croane651/MAE-342-Project/MEE342_Geneva_Drive_Assem1.SLDASM

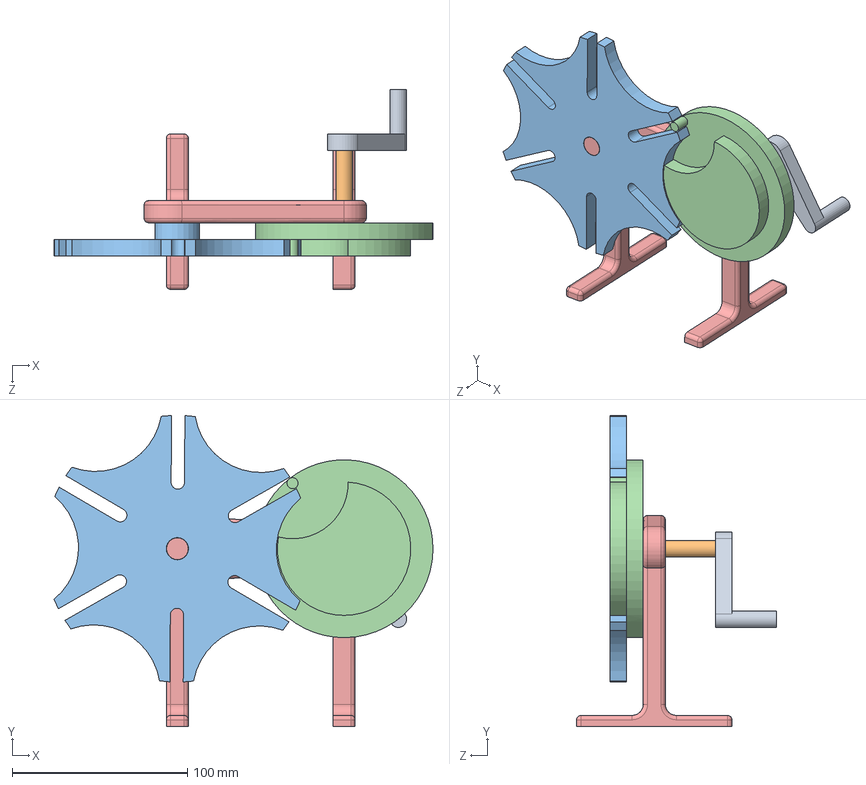
[picture p22: CAD file, 2026-03-21]
MEE342_Geneva_Drive_Assem1.SLDASM
216.5 x 177.7 x 114.3 mm
Geneva_Drive_Gear_Bracket
Geneva_Driver_Wheel
Geneva_Wheel
Geneva_Drive_CrankShaft
Geneva_Drive_Crank
