croane651/MAE-342-Project/Geneva_Driver_Wheel.SLDPRT

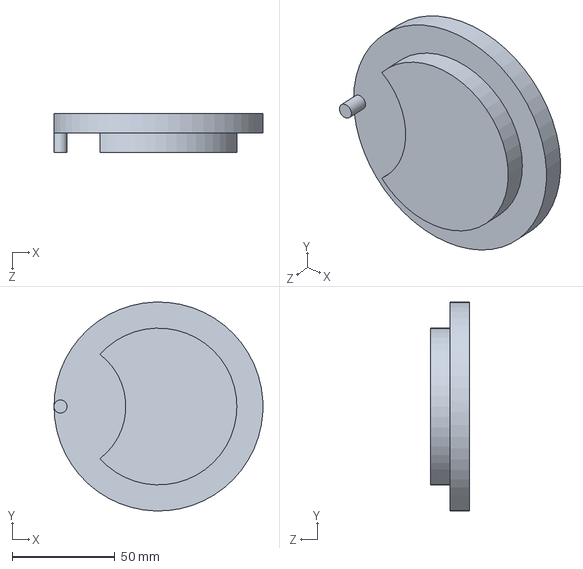
[picture p23: CAD file, 2026-03-21]
Geneva_Driver_Wheel.SLDPRT
101.6 x 101.6 x 19.1 mm
