croane651/MAE-342-Project/Geneva_Wheel.SLDPRT

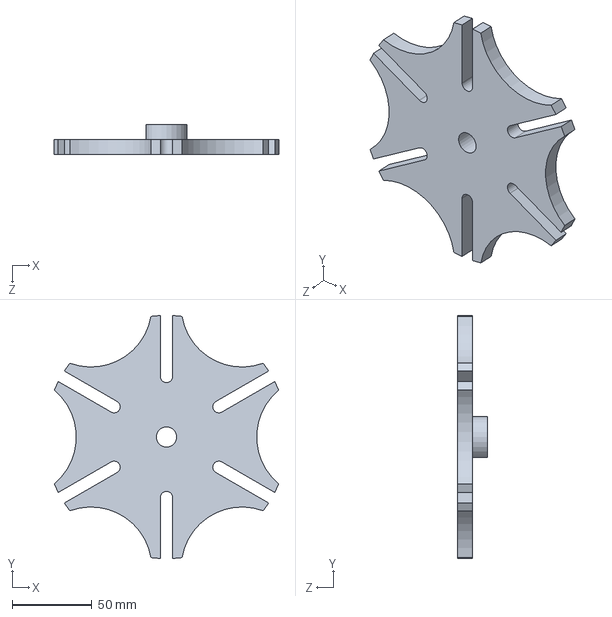
[picture p24: CAD file, 2026-03-21]
Geneva_Wheel.SLDPRT
140.6 x 152.2 x 19.1 mm
