croane651/MAE-342-Project/Geneva_Drive_Crank.SLDPRT

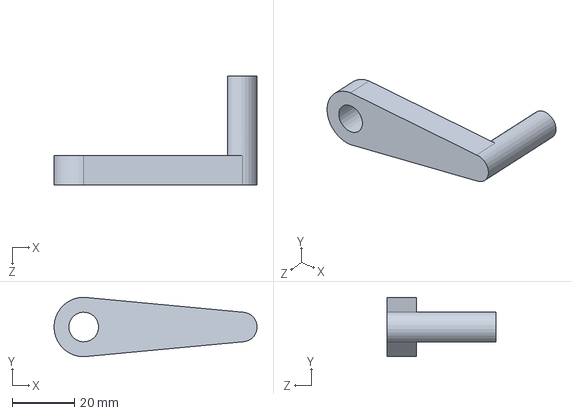
[picture p25: CAD file, 2026-03-21]
Geneva_Drive_Crank.SLDPRT
65.0 x 19.1 x 34.9 mm
