croane651/MAE-342-Project/Geneva_Drive_CrankShaft.SLDPRT

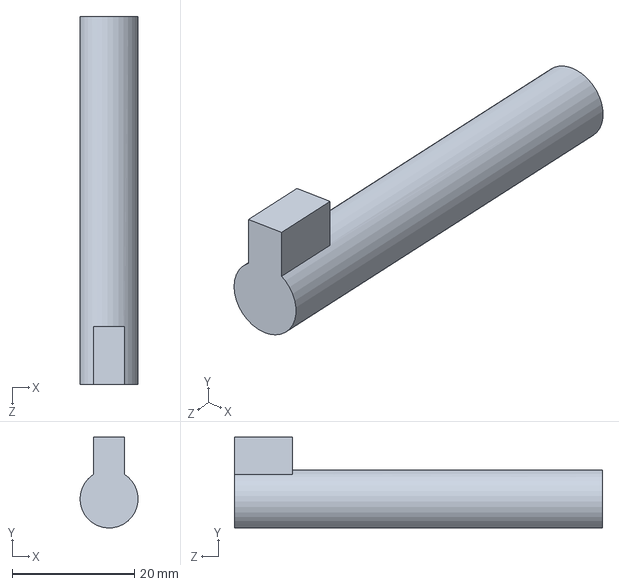
[picture p26: CAD file, 2026-03-21]
Geneva_Drive_CrankShaft.SLDPRT
9.50 x 14.9 x 60.3 mm
