croane651/MAE-342-Project/Geneva_Drive_Gear_Bracket.SLDPRT

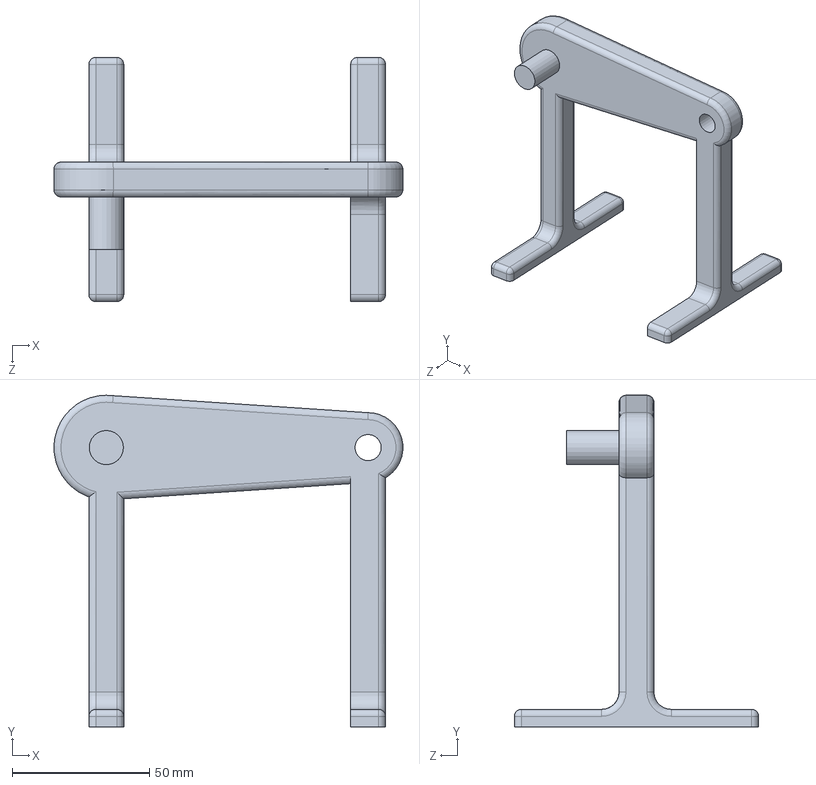
[picture p27: CAD file, 2026-03-21]
Geneva_Drive_Gear_Bracket.SLDPRT
127.0 x 120.6 x 88.9 mm
