croane651/MAE-342-Project/(list of files, cad)

Other CAD files:
Geneva_Drive_CrankShaft_Drawing.SLDDRW
Geneva_Drive_Crank_Drawing.SLDDRW
Geneva_Drive_Gear_Bracket_drawing.SLDDRW
Geneva_Driver_Wheel_Drawing.SLDDRW
Geneva_Wheel_Drawing.SLDDRW
